YoonGroupUmich/osc1lite/hardware/17.srcs/sources_1/imports/Program Files/Opal Kelly/FrontPanelUSB/FrontPanelHDL/XEM7001-A15/okBTPipeIn.v

// Copyright 1986-2016 Xilinx, Inc. All Rights Reserved.
// --------------------------------------------------------------------------------
// Tool Version: Vivado v.2016.2 (win64) Build 1577090 Thu Jun  2 16:32:40 MDT 2016
// Date        : Thu Oct 06 16:19:22 2016
// Host        : ENG001 running 64-bit major release  (build 9200)
// Command     : write_verilog encrypted/okBTPipeIn.v -force
// Design      : okBTPipeIn
// Purpose     : This is a Verilog netlist of the current design or from a specific cell of the design. The output is an
//               IEEE 1364-2001 compliant Verilog HDL file that contains netlist information obtained from the input
//               design files.
// Device      : xc7a15tftg256-1
// --------------------------------------------------------------------------------
`timescale 1 ps / 1 ps
`pragma protect begin_protected
`pragma protect version = 1
`pragma protect encrypt_agent = "XILINX"
`pragma protect encrypt_agent_info = "Xilinx Encryption Tool 2014"
`pragma protect key_keyowner="Xilinx", key_keyname="xilinx_rsa_key", key_method="rsa"
`pragma protect encoding = (enctype="BASE64", line_length=76, bytes=256)
`pragma protect key_block
3OlYn7HazbDq2HMwi5RyvUmbHzxC1Ebx+/FZ0o5FNVukCUtgxBSQJG6t8s8oLNsBGPliOKv0TzFc
t42pqf57li0rMTcpcXP9PWjuzLnZAKVM7WI/clsn4oYKbBiEfpixM7DIxbp6anocykExR+eRh5lO
MAtx/pkbg/xr+Sp/DSgTmhQBrDajQcE3jdUKGGTdVj6DbtxCrpLS5tMfQrIUn6x1GEcm/oUvmooY
C7L6Vo0zkQfJZ14ivMKtiWcA+ntlEbrK0EoROwJJCriWGsVWR0dZOLndyrch/hncqhNZQ71ABkn+
wfOAjCzXsL8fD+oGOANA4dV061zjG0dehJdDhw==

`pragma protect data_method = "AES128-CBC"
`pragma protect encoding = (enctype = "BASE64", line_length = 76, bytes = 5392)
`pragma protect data_block
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
`pragma protect end_protected
