YoonGroupUmich/osc1lite/hardware/17.srcs/sources_1/imports/Program Files/Opal Kelly/FrontPanelUSB/FrontPanelHDL/XEM7001-A15/okBTPipeOut.v

// Copyright 1986-2016 Xilinx, Inc. All Rights Reserved.
// --------------------------------------------------------------------------------
// Tool Version: Vivado v.2016.2 (win64) Build 1577090 Thu Jun  2 16:32:40 MDT 2016
// Date        : Thu Oct 06 16:19:29 2016
// Host        : ENG001 running 64-bit major release  (build 9200)
// Command     : write_verilog encrypted/okBTPipeOut.v -force
// Design      : okBTPipeOut
// Purpose     : This is a Verilog netlist of the current design or from a specific cell of the design. The output is an
//               IEEE 1364-2001 compliant Verilog HDL file that contains netlist information obtained from the input
//               design files.
// Device      : xc7a15tftg256-1
// --------------------------------------------------------------------------------
`timescale 1 ps / 1 ps
`pragma protect begin_protected
`pragma protect version = 1
`pragma protect encrypt_agent = "XILINX"
`pragma protect encrypt_agent_info = "Xilinx Encryption Tool 2014"
`pragma protect key_keyowner="Xilinx", key_keyname="xilinx_rsa_key", key_method="rsa"
`pragma protect encoding = (enctype="BASE64", line_length=76, bytes=256)
`pragma protect key_block
iiAk9TBSkcCasBPK33q2s7r/luqs4qaLwQ+dElc3P8TG3BykAMEKBeGPr77RI5bVUK63n0Xj2X51
MdnUcv1obS6MIUx5+59yaEHYXAa2sCgD6VrBtXdjif7CoM4OtYVjkTOCvFF6Se2nzNsQ9SyLy/wc
WIKnA53HOlyTeasF3Vr0asaeUzH/ZJU4Cl1zHTsFcQ3Ei/va9sNJrpMzy2ARL8pYPedIPrjEQTTM
1oAVN3OCh3v+av8t1timowmi2hXvtXZiGqvWfRyD4fmkc8sVl8d1RuUZuddb7tLpFT8wPdG8NWID
HycKMu1T2lVTeKs6GGNP3nSpwWNLf67xXmiP9Q==

`pragma protect data_method = "AES128-CBC"
`pragma protect encoding = (enctype = "BASE64", line_length = 76, bytes = 5536)
`pragma protect data_block
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
repFMXIU1A==
`pragma protect end_protected
