YoonGroupUmich/osc1lite/hardware/17.srcs/sources_1/imports/Program Files/Opal Kelly/FrontPanelUSB/FrontPanelHDL/XEM7001-A15/okLibrary.vhd

------------------------------------------------------------------------
-- FrontPanel Library Module Declarations (VHDL)
-- XEM7001
--
-- IDELAY and IODELAY fixed delays were determined empirically to meet
-- timing for particular devices on particular products.
--
-- Copyright (c) 2004-2011 Opal Kelly Incorporated
-- $Rev: 980 $ $Date: 2011-08-19 12:17:52 -0700 (Fri, 19 Aug 2011) $
------------------------------------------------------------------------

library IEEE;
use IEEE.STD_LOGIC_1164.ALL;
library UNISIM;
use UNISIM.vcomponents.all;
entity okHost is
	port (
		hi_in    : in std_logic_vector(7 downto 0);
		hi_out   : out std_logic_vector(1 downto 0);
		hi_inout : inout std_logic_vector(15 downto 0);
		hi_aa    : inout std_logic;
		ti_clk   : out std_logic;
		ok1      : out std_logic_vector(30 downto 0);
		ok2      : in std_logic_vector(16 downto 0)
	);
end okHost;

architecture archHost of okHost is
	attribute box_type: string;
	attribute iob: string;
	
	component okCoreHarness port (
		okHC   : in    std_logic_vector(24 downto 0);
		okCH   : out   std_logic_vector(20 downto 0);
		ok1    : out   std_logic_vector(30 downto 0);
		ok2    : in    std_logic_vector(16 downto 0));
	end component;
	attribute box_type of okCoreHarness : component is "black_box";
	
	component FDRE port (
		D  : in    std_logic;
		C  : in    std_logic;
		CE : in    std_logic;
		R  : in    std_logic;
		Q  : out   std_logic);
	end component;
	attribute iob of FDRE  : component is "TRUE";
	
	signal okHC            : std_logic_vector(24 downto 0);
	signal okCH            : std_logic_vector(20 downto 0);
	
	signal iobf0_hi_datain : std_logic_vector(15 downto 0);
	signal hi_datain       : std_logic_vector(15 downto 0);
	
	signal fdreout0_hi_dataout  : std_logic_vector(15 downto 0);
	signal fdreout1_hi_drive    : std_logic_vector(15 downto 0);
	signal not_okCH2            : std_logic;
	
	signal ti_clk_int       : std_logic;

	signal mmcm0_clk0       : std_logic;
	signal mmcm0_clk0_bufg  : std_logic;
	signal mmcm0_clkfb      : std_logic;
	signal mmcm0_clkfb_bufg : std_logic;
	signal mmcm0_locked     : std_logic;
	signal hi_in0_ibufg     : std_logic;
	
begin
	okHC(0)            <= ti_clk_int;
	okHC(7 downto 1)   <= hi_in(7 downto 1);
	okHC(23 downto 8)  <= hi_datain;
	ti_clk             <= ti_clk_int;
	not_okCH2          <= not(okCH(2));
	
	-- Clock buffer for the Host Interface clock.
	hi_in0_bufg : IBUFG port map (I=>hi_in(0), O=>hi_in0_ibufg);

	mmcm0: MMCME2_BASE generic map (
		BANDWIDTH        => "OPTIMIZED",      -- Jitter programming (OPTIMIZED, HIGH, LOW)
		CLKFBOUT_MULT_F  => 20.0,             -- Multiply value for all CLKOUT (2.000-64.000).
		CLKFBOUT_PHASE   => 0.0,              -- Phase offset in degrees of CLKFB (-360.000-360.000).
		CLKIN1_PERIOD    => 20.833,           -- Input clock period in ns to ps resolution (i.e. 33.333 is 30 MHz).
		CLKOUT0_DIVIDE_F => 20.0,             -- Divide amount for CLKOUT0 (1.000-128.000).
		CLKOUT0_PHASE    => 4.5,              -- Phase offset for each CLKOUT (-360.000-360.000).
		DIVCLK_DIVIDE    => 1,                -- Master division value (1-106)
		REF_JITTER1      => 0.0,              -- Reference input jitter in UI (0.000-0.999).
		STARTUP_WAIT     => FALSE             -- Delays DONE until MMCM is locked (FALSE, TRUE)
	) port map (
		CLKOUT0          => mmcm0_clk0,       -- 1-bit output: CLKOUT0
		CLKFBOUT         => mmcm0_clkfb,      -- 1-bit output: Feedback clock
		LOCKED           => mmcm0_locked,     -- 1-bit output: LOCK
		CLKIN1           => hi_in0_ibufg,     -- 1-bit input: Clock
		PWRDWN           => '0',              -- 1-bit input: Power-down input
		RST              => '0',              -- 1-bit input: Reset
		CLKFBIN          => mmcm0_clkfb_bufg  -- 1-bit input: Feedback clock
	);
	
	mmcm0_bufg   : BUFG port map (I=>mmcm0_clk0,  O=>ti_clk_int);
	mmcm0fb_bufg : BUFG port map (I=>mmcm0_clkfb, O=>mmcm0_clkfb_bufg);

	-- IOBs for hi_inout
	
	delays : for i in 0 to 15 generate
		
		-- Input Delay and Registering
		iobf0: IOBUF port map(
				IO => hi_inout(i),
				I  => fdreout0_hi_dataout(i), 
				O  => iobf0_hi_datain(i), 
				T  => fdreout1_hi_drive(i) 
			);
			
			fdrein0: FDRE port map(
				D  => iobf0_hi_datain(i),
				C  => ti_clk_int,
				CE => '1',
				R  => '0',
				Q  => hi_datain(i)
			);
			
			-- Output Registering
			fdreout0: FDRE port map(
				D  => okCH(i+3),
				C  => ti_clk_int,
				CE => '1',
				R  => '0',
				Q  => fdreout0_hi_dataout(i)
			);

			fdreout1: FDRE port map(
				D  => not_okCH2,
				C  => ti_clk_int,
				CE => '1',
				R  => '0',
				Q  => fdreout1_hi_drive(i)
			);
			
	end generate delays;
	

	obuf0 : OBUF  port map (I=>okCH(0), O=>hi_out(0));
	obuf1 : OBUF  port map (I=>okCH(1), O=>hi_out(1));
	tbuf  : IOBUF port map (I=>okCH(19), O=>okHC(24), T=>okCH(20), IO=>hi_aa);

	core0 : okCoreHarness port map(okHC=>okHC, okCH=>okCH, ok1=>ok1, ok2=>ok2);
end archHost;


library IEEE;
use IEEE.STD_LOGIC_1164.ALL;
entity okWireOR is
	generic (
		N     : integer := 1
	);
	port (
		ok2   : out std_logic_vector(16 downto 0);
		ok2s  : in  std_logic_vector(N*17-1 downto 0)
	);
end okWireOR;
architecture archWireOR of okWireOR is
begin
	process (ok2s)
		variable ok2_int : STD_LOGIC_VECTOR(16 downto 0);
	begin
		ok2_int := b"0_0000_0000_0000_0000";
		for i in N-1 downto 0 loop
			ok2_int := ok2_int or ok2s( (i*17+16) downto (i*17) );
		end loop;
		ok2 <= ok2_int;
	end process;
end archWireOR;


library IEEE;
use IEEE.STD_LOGIC_1164.ALL;
package FRONTPANEL is

	attribute box_type: string;
	
	component okHost port (
		hi_in    : in std_logic_vector(7 downto 0);
		hi_out   : out std_logic_vector(1 downto 0);
		hi_inout : inout std_logic_vector(15 downto 0);
		hi_aa    : inout std_logic;
		ti_clk   : out std_logic;
		ok1      : out std_logic_vector(30 downto 0);
		ok2      : in std_logic_vector(16 downto 0));
	end component;

	component okCoreHarness port (
		okHC   : in    std_logic_vector(24 downto 0);
		okCH   : out   std_logic_vector(20 downto 0);
		ok1    : out   std_logic_vector(30 downto 0);
		ok2    : in    std_logic_vector(16 downto 0));
	end component;
	attribute box_type of okCoreHarness : component is "black_box";

	component okWireIn port (
		ok1        : in std_logic_vector(30 downto 0);
		ep_addr    : in std_logic_vector(7 downto 0);
		ep_dataout : out std_logic_vector(15 downto 0));
	end component;
	attribute box_type of okWireIn : component is "black_box";

	component okWireOut port (
		ok1       : in std_logic_vector(30 downto 0);
		ok2       : out std_logic_vector(16 downto 0);
		ep_addr   : in std_logic_vector(7 downto 0);
		ep_datain : in std_logic_vector(15 downto 0));
	end component;
	attribute box_type of okWireOut : component is "black_box";

	component okTriggerIn port (
		ok1        : in std_logic_vector(30 downto 0);
		ep_addr    : in std_logic_vector(7 downto 0);
		ep_clk     : in std_logic;
		ep_trigger : out std_logic_vector(15 downto 0));
	end component;
	attribute box_type of okTriggerIn : component is "black_box";

	component okTriggerOut port (
		ok1        : in std_logic_vector(30 downto 0);
		ok2        : out std_logic_vector(16 downto 0);
		ep_addr    : in std_logic_vector(7 downto 0);
		ep_clk     : in std_logic;
		ep_trigger : in std_logic_vector(15 downto 0));
	end component;
	attribute box_type of okTriggerOut : component is "black_box";

	component okPipeIn port (
		ok1        : in std_logic_vector(30 downto 0);
		ok2        : out std_logic_vector(16 downto 0);
		ep_addr    : in std_logic_vector(7 downto 0);
		ep_write   : out std_logic;
		ep_dataout : out std_logic_vector(15 downto 0));
	end component;
	attribute box_type of okPipeIn : component is "black_box";

	component okPipeOut port (
		ok1        : in std_logic_vector(30 downto 0);
		ok2        : out std_logic_vector(16 downto 0);
		ep_addr    : in std_logic_vector(7 downto 0);
		ep_read    : out std_logic;
		ep_datain  : in std_logic_vector(15 downto 0));
	end component;
	attribute box_type of okPipeOut : component is "black_box";

	component okBTPipeIn port (
		ok1            : in std_logic_vector(30 downto 0);
		ok2            : out std_logic_vector(16 downto 0);
		ep_addr        : in std_logic_vector(7 downto 0);
		ep_write       : out std_logic;
		ep_blockstrobe : out std_logic;
		ep_dataout     : out std_logic_vector(15 downto 0);
		ep_ready       : in std_logic);
	end component;
	attribute box_type of okBTPipeIn : component is "black_box";

	component okBTPipeOut port (
		ok1            : in std_logic_vector(30 downto 0);
		ok2            : out std_logic_vector(16 downto 0);
		ep_addr        : in std_logic_vector(7 downto 0);
		ep_read        : out std_logic;
		ep_blockstrobe : out std_logic;
		ep_datain      : in std_logic_vector(15 downto 0);
		ep_ready       : in std_logic);
	end component;
	attribute box_type of okBTPipeOut : component is "black_box";

	component okWireOR
	generic (N : integer := 1);
	port (
		ok2   : out std_logic_vector(16 downto 0);
		ok2s  : in  std_logic_vector(N*17-1 downto 0));
	end component;

end FRONTPANEL;
