YoonGroupUmich/osc1lite/hardware/17.srcs/sources_1/imports/Program Files/Opal Kelly/FrontPanelUSB/FrontPanelHDL/XEM7001-A15/okWireIn.v

// Copyright 1986-2016 Xilinx, Inc. All Rights Reserved.
// --------------------------------------------------------------------------------
// Tool Version: Vivado v.2016.2 (win64) Build 1577090 Thu Jun  2 16:32:40 MDT 2016
// Date        : Thu Oct 06 16:20:06 2016
// Host        : ENG001 running 64-bit major release  (build 9200)
// Command     : write_verilog encrypted/okWireIn.v -force
// Design      : okWireIn
// Purpose     : This is a Verilog netlist of the current design or from a specific cell of the design. The output is an
//               IEEE 1364-2001 compliant Verilog HDL file that contains netlist information obtained from the input
//               design files.
// Device      : xc7a15tftg256-1
// --------------------------------------------------------------------------------
`timescale 1 ps / 1 ps
`pragma protect begin_protected
`pragma protect version = 1
`pragma protect encrypt_agent = "XILINX"
`pragma protect encrypt_agent_info = "Xilinx Encryption Tool 2014"
`pragma protect key_keyowner="Xilinx", key_keyname="xilinx_rsa_key", key_method="rsa"
`pragma protect encoding = (enctype="BASE64", line_length=76, bytes=256)
`pragma protect key_block
efMknPhS90fa9pMaETM3UyB6T4VSC89lGfLh6OSXmlIKhW1FrWp2OtFYcAr6loyiZSLBvLBXsLoK
GTPJdkn/7/vkKDeoqWx+uzfIoOmud732L2yyB5N1PTHjWLc+vEiHP4HjkBSfM9MyUk2G3pPtIuCR
i9MxPhh0fKv6G0K4Hq5yPq50oKQA7stGEiCYgUu9k8zR4kNzkl6G0u4EwRLDWY6fIfbRGprymw9Y
UWjX9BMjfNh06B+tPp+oY+dI+H8Fc/BGKOJIvmDSJz6N5qruZgLRRJUk7n2AZwQooYbWl/9WJJlc
nMYJaxmvXQUvQDenc4aY2468DKnYwbQ3Ckn4Ow==

`pragma protect data_method = "AES128-CBC"
`pragma protect encoding = (enctype = "BASE64", line_length = 76, bytes = 6432)
`pragma protect data_block
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
`pragma protect end_protected
