YoonGroupUmich/osc1lite/hardware/17.srcs/sources_1/imports/Program Files/Opal Kelly/FrontPanelUSB/FrontPanelHDL/XEM7001-A15/okWireOut.v

// Copyright 1986-2016 Xilinx, Inc. All Rights Reserved.
// --------------------------------------------------------------------------------
// Tool Version: Vivado v.2016.2 (win64) Build 1577090 Thu Jun  2 16:32:40 MDT 2016
// Date        : Thu Oct 06 16:20:13 2016
// Host        : ENG001 running 64-bit major release  (build 9200)
// Command     : write_verilog encrypted/okWireOut.v -force
// Design      : okWireOut
// Purpose     : This is a Verilog netlist of the current design or from a specific cell of the design. The output is an
//               IEEE 1364-2001 compliant Verilog HDL file that contains netlist information obtained from the input
//               design files.
// Device      : xc7a15tftg256-1
// --------------------------------------------------------------------------------
`timescale 1 ps / 1 ps
`pragma protect begin_protected
`pragma protect version = 1
`pragma protect encrypt_agent = "XILINX"
`pragma protect encrypt_agent_info = "Xilinx Encryption Tool 2014"
`pragma protect key_keyowner="Xilinx", key_keyname="xilinx_rsa_key", key_method="rsa"
`pragma protect encoding = (enctype="BASE64", line_length=76, bytes=256)
`pragma protect key_block
GSYWwEHlxfjEaM2gJRKm6mOtosCn+chAGAW4EaptvHZfuRP4vyc9VYa2mdVX2uB501HMiSWrfAv7
TLry8pL+E/+9TenMFGBFCfvdmPMm0N4CBtrT5d6NQOUr29jIHxzfNZAuc8e+5Zpk6Fr2b6NPA8WJ
4Tyz+9OMaygdTCVoCHgZ7KvtkXBi8rsNVMDjddBW9FcxP99TW9igr9SduN2F8p0KtbnAjBxaSL5C
XTi2Id0o0chgAktMJ852iF2+SPZ82rEO1UxZaRUMJu4q37uu9he4ZfZx/rrQqvJ23y3jgmLkXFUN
hX7evMgWj8MpZ8JfEYSOsDjTvR7wrBzNAc0LGw==

`pragma protect data_method = "AES128-CBC"
`pragma protect encoding = (enctype = "BASE64", line_length = 76, bytes = 7312)
`pragma protect data_block
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
UQiw+Ei32kjUs+jTov4wTw==
`pragma protect end_protected
