YoonGroupUmich/osc1lite/hardware/17.srcs/sources_1/imports/Program Files/Opal Kelly/FrontPanelUSB/FrontPanelHDL/XEM7001-A15/okPipeIn.v

// Copyright 1986-2016 Xilinx, Inc. All Rights Reserved.
// --------------------------------------------------------------------------------
// Tool Version: Vivado v.2016.2 (win64) Build 1577090 Thu Jun  2 16:32:40 MDT 2016
// Date        : Thu Oct 06 16:19:37 2016
// Host        : ENG001 running 64-bit major release  (build 9200)
// Command     : write_verilog encrypted/okPipeIn.v -force
// Design      : okPipeIn
// Purpose     : This is a Verilog netlist of the current design or from a specific cell of the design. The output is an
//               IEEE 1364-2001 compliant Verilog HDL file that contains netlist information obtained from the input
//               design files.
// Device      : xc7a15tftg256-1
// --------------------------------------------------------------------------------
`timescale 1 ps / 1 ps
`pragma protect begin_protected
`pragma protect version = 1
`pragma protect encrypt_agent = "XILINX"
`pragma protect encrypt_agent_info = "Xilinx Encryption Tool 2014"
`pragma protect key_keyowner="Xilinx", key_keyname="xilinx_rsa_key", key_method="rsa"
`pragma protect encoding = (enctype="BASE64", line_length=76, bytes=256)
`pragma protect key_block
Fi2SADsNrNP2iYLcBepO+3vSv2htJBH8FzQCw3kKjySlScoX79UjdTeyCxiAmekKrhz2OX2Z7dpG
gL/YErT7Q+yV2zD85XaQjJfIa6McgWpoOQOIBoH3S3/ZggG3aeJCKHHkC6mQYP21peH5CtM7deK3
ot/cs5kl0o1IuHEhHwaZsgeUjvuzp2PxX8vris8E0vIfxKrWG/wImoe8a3+1H/wvUOAZVXzCV5gu
HzrFFwq+iIyLriyOFN7E/+NJSjJFmmPSk3DepwoC/NVzpAmE9UCa9fbFW8qlhZNTrlQhn+8yfcDO
UtDZLKeWEmAGeK1NcNaXZZ1VWFmGCZhz680ZkQ==

`pragma protect data_method = "AES128-CBC"
`pragma protect encoding = (enctype = "BASE64", line_length = 76, bytes = 5328)
`pragma protect data_block
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
qtEMCXeXFiwqVdrjfddtTUiLO2vHGnoM5UOS
`pragma protect end_protected
