YoonGroupUmich/osc1lite/hardware/17.srcs/sources_1/imports/Program Files/Opal Kelly/FrontPanelUSB/FrontPanelHDL/XEM7001-A15/okPipeOut.v

// Copyright 1986-2016 Xilinx, Inc. All Rights Reserved.
// --------------------------------------------------------------------------------
// Tool Version: Vivado v.2016.2 (win64) Build 1577090 Thu Jun  2 16:32:40 MDT 2016
// Date        : Thu Oct 06 16:19:44 2016
// Host        : ENG001 running 64-bit major release  (build 9200)
// Command     : write_verilog encrypted/okPipeOut.v -force
// Design      : okPipeOut
// Purpose     : This is a Verilog netlist of the current design or from a specific cell of the design. The output is an
//               IEEE 1364-2001 compliant Verilog HDL file that contains netlist information obtained from the input
//               design files.
// Device      : xc7a15tftg256-1
// --------------------------------------------------------------------------------
`timescale 1 ps / 1 ps
`pragma protect begin_protected
`pragma protect version = 1
`pragma protect encrypt_agent = "XILINX"
`pragma protect encrypt_agent_info = "Xilinx Encryption Tool 2014"
`pragma protect key_keyowner="Xilinx", key_keyname="xilinx_rsa_key", key_method="rsa"
`pragma protect encoding = (enctype="BASE64", line_length=76, bytes=256)
`pragma protect key_block
Q+yaEaaYOgZy+5iiFYRg4G5q4tuQzfPr+poAHkR8Z/a41t9999TViKRofw6kYSffn/ziz7rTgrmC
q0HEylBbgqwXvHGTFkf1XxKSWueTRQ480sHKoOiGZuyIv6EkbpXFgRiTLG23ESgv2erERXds3hOD
dI0L0Z/NVRusgILCdF3I6UcLGBiRfKPiVLbKi1z4Oojtp5z/HC/AhL+BR9w6etzgZv5xVt0IX+fN
uaJCcrfWi+geBp5gJyQeREuHVU+TAoT5A8p0DSgAYqXTnchgR3qMsyRiQ7eJProdohhZH0SunePx
LLWs32N9Ht32kEbCRk9Nq5WBofRU7eQ3YqM5HA==

`pragma protect data_method = "AES128-CBC"
`pragma protect encoding = (enctype = "BASE64", line_length = 76, bytes = 5232)
`pragma protect data_block
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
`pragma protect end_protected
