YoonGroupUmich/osc1lite/(commit log)

2019-07-17 Major GUI update
    Add per channel "Stop" button
    Add PC/external trigger logic
    Add continuous mode logic
    Add software version number on the Matlab GUI
2019-07-18 Major GUI update
    Allow user to modify parameters even if board not connected
    Add trigger out button
    Reposition waveform parameters panel
    Add "Delete" button for waveforms
2019-07-25 Add custom waveform support in Python GUI
    Add Lock in osc1lite.py to ensure thread safety
2019-08-29 Add board testing procedure
2019-09-24 remove old file locations (random, unorganized). Track project file 17.xpr (which now reflects the moved .v files)
2019-09-30 Add calibration in software
2019-09-30 Add calibration in verilog
2019-10-05 Add resistor to calibration
2019-10-29 Add 5kOhm pulldown on trigger in pins
    To prevent noise triggering floating pins
    [xem7001.xdc]
2019-10-29 Give a log when failed to open a device
2019-12-13 Add sample script for the API
2019-12-13 Handle button enable/disable when loading config
2019-12-13 Use new Opal Kelly handle for each device listing
    This fixes a bug where new board won't be detected until restart OSCGUI
2020-01-10 API clean up
    Remove the deprecated ext_trig parameter
    Store the calibration data as part of the OSC1Lite object
2020-05-29 Add OpalKelly wire protocol document
    [wire protocol.xlsx]
2020-06-10 Add wire protocol for sending custom waveform
    [wire protocol.xlsx]
2020-06-17 Add custom waveform in Verilog
    [wire protocol.xlsx]
2020-06-22 Fix custom waveform BRAM read
    [OSC1_LITE_one_channel_control.v, memory_read_tdm.v, read_input.v]
